CryptoIceMLH/SolarBit/Prototype/README.md

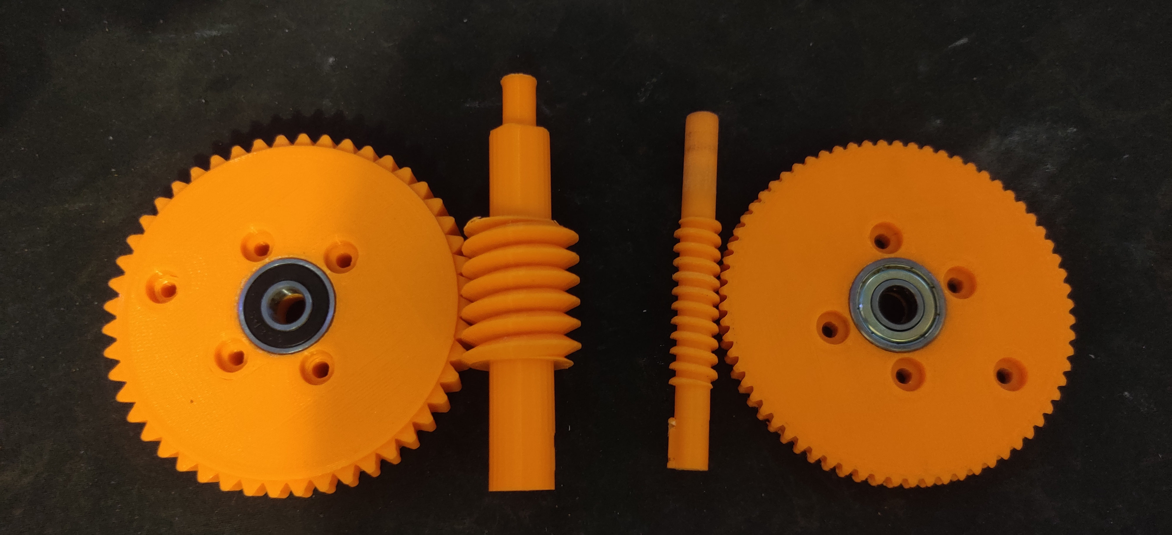
[picture p3: Prototype/IMG_20240215_163127.jpg]

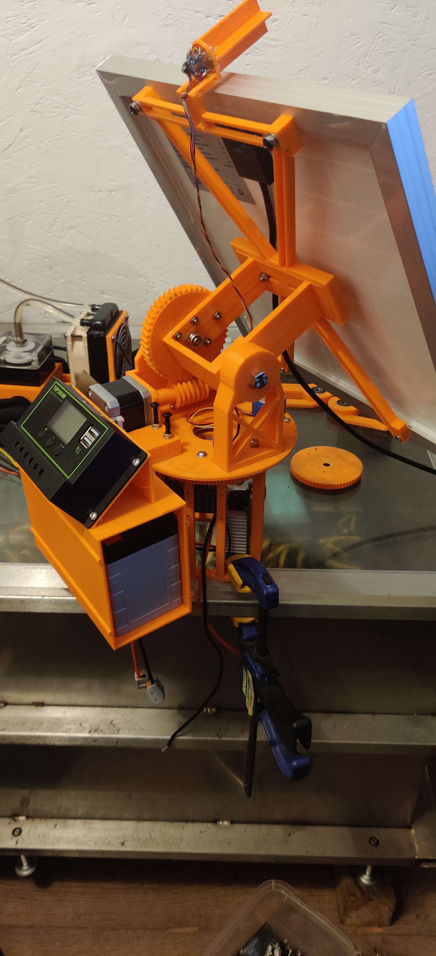
[picture p4: Prototype/IMG_20240217_124240.jpg]

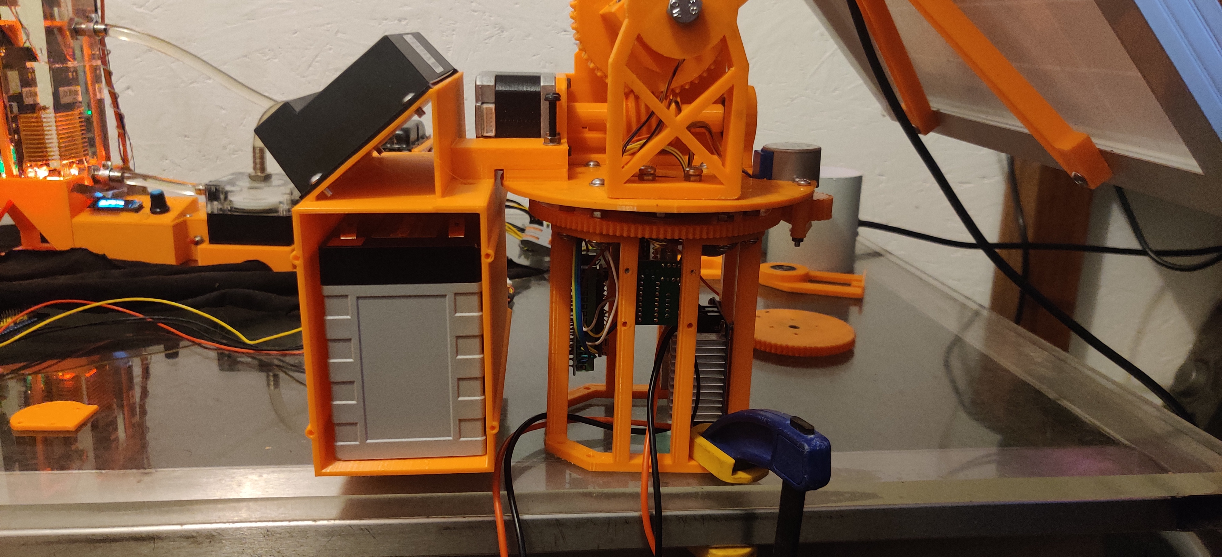
[picture p5: Prototype/IMG_20240217_124309.jpg]

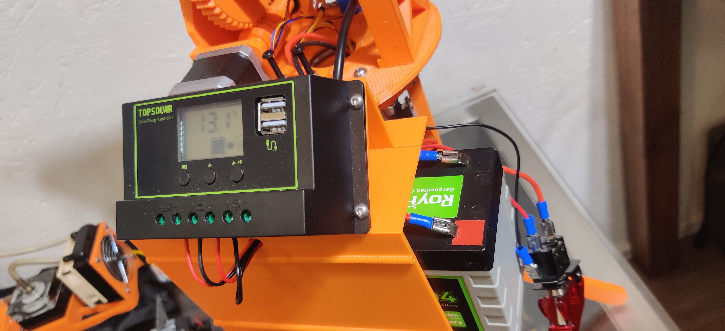
[picture p6: Prototype/IMG_20240220_164915.jpg]

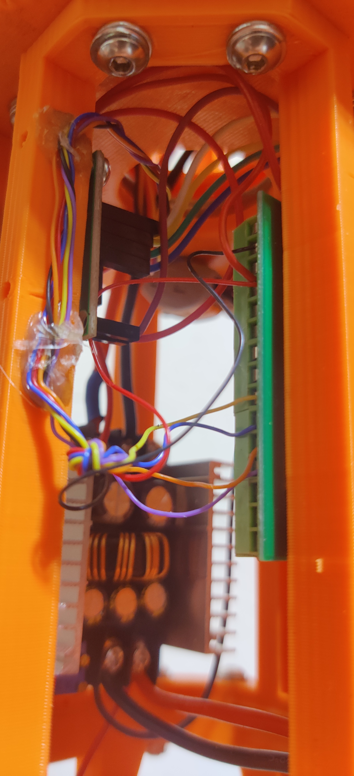
[picture p7: Prototype/IMG_20240220_165518.jpg]

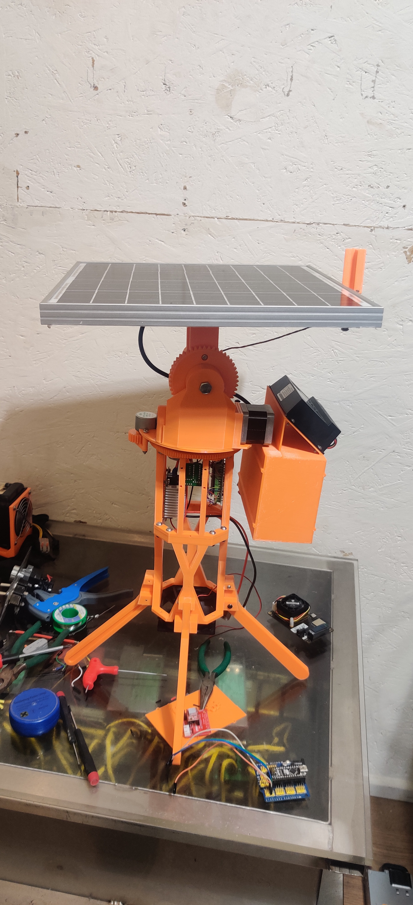
[picture p8: Prototype/IMG_20240220_183023.jpg]

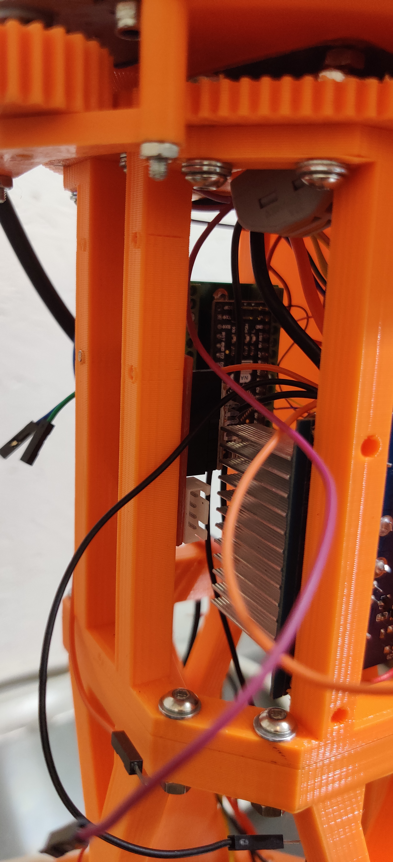
[picture p9: Prototype/IMG_20240314_140523.jpg]

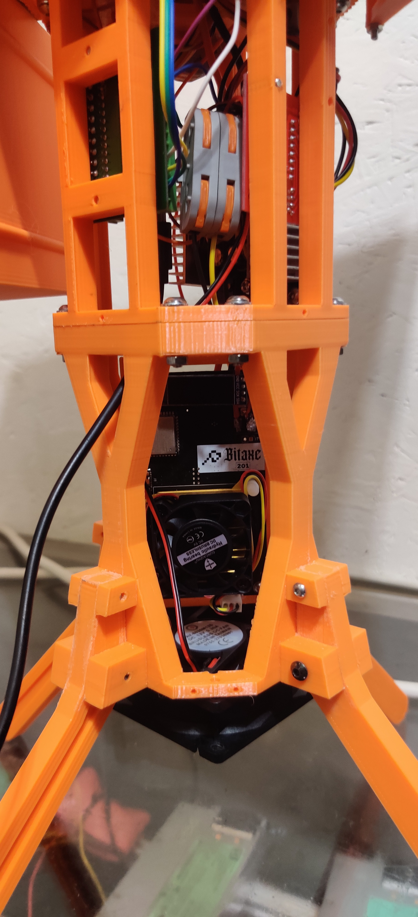
[picture p10: Prototype/IMG_20240314_154743.jpg]

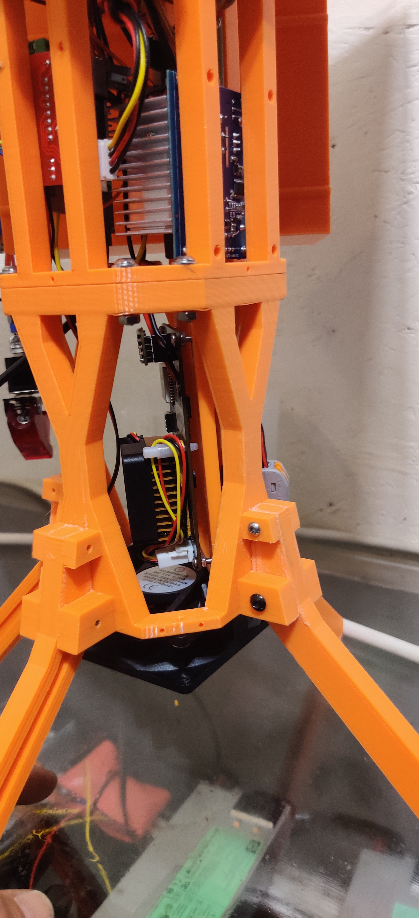
[picture p11: Prototype/IMG_20240314_154749.jpg]

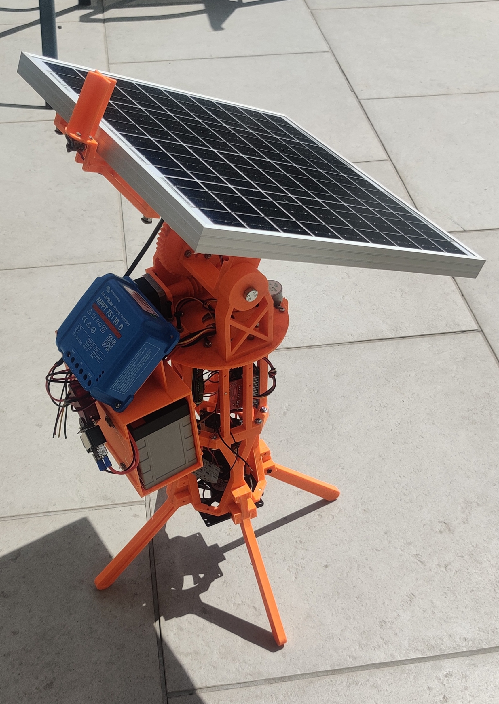
[picture p12: Prototype/IMG_20240616_144431.jpg]


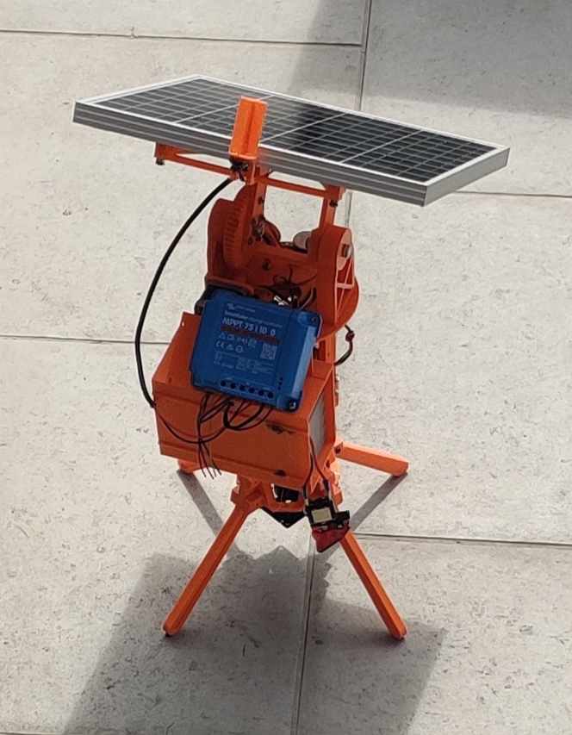
[picture p14: Prototype/IMG_20240618_124644.jpg]

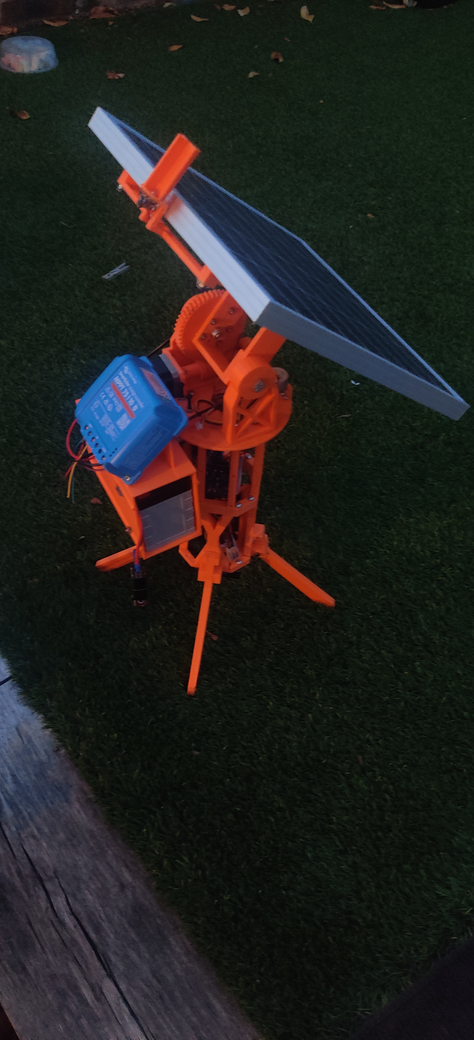
[picture p15: Prototype/IMG_20240717_213533.jpg]

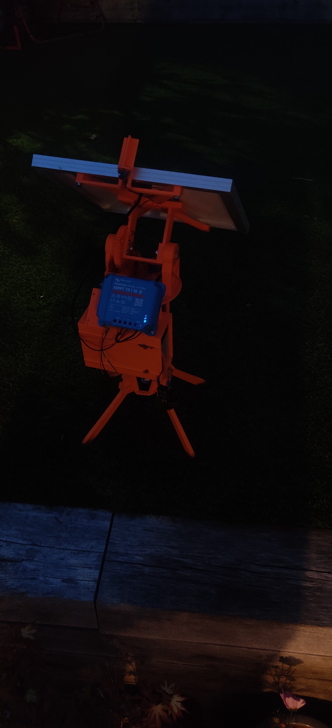
[picture p16: Prototype/IMG_20240717_214945.jpg]
