CryptoIceMLH/SolarBit/img/Gk3GHBeXMAATnz1.jpg

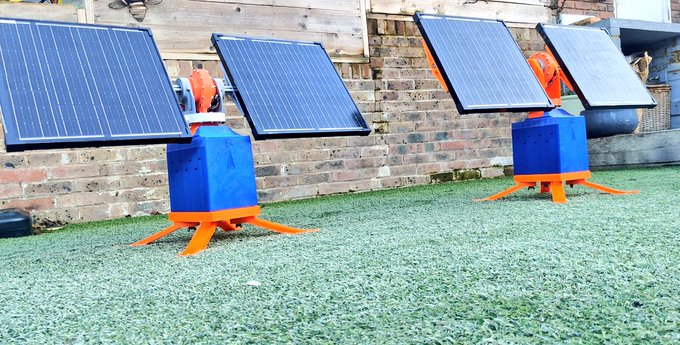
img/Gk3GHBeXMAATnz1.jpg
