CryptoIceMLH/SolarBit/img/SolarbitColorCode.jpg

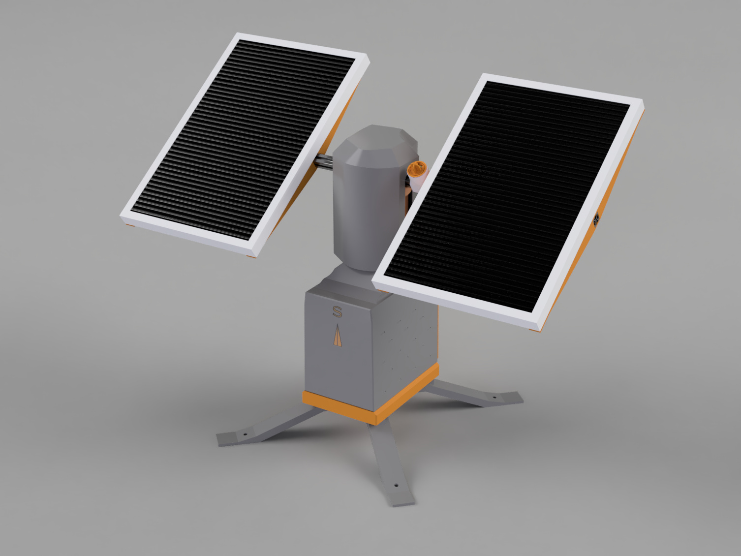
img/SolarbitColorCode.jpg
