CryptoIceMLH/SolarBit/img/SolarbitColorCode.png

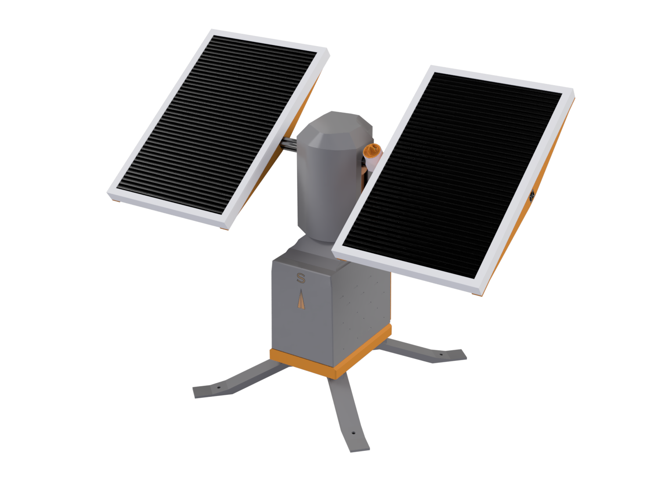
img/SolarbitColorCode.png
