CryptoIceMLH/SolarBit/3D Files/Cable Management/CableClip.stl

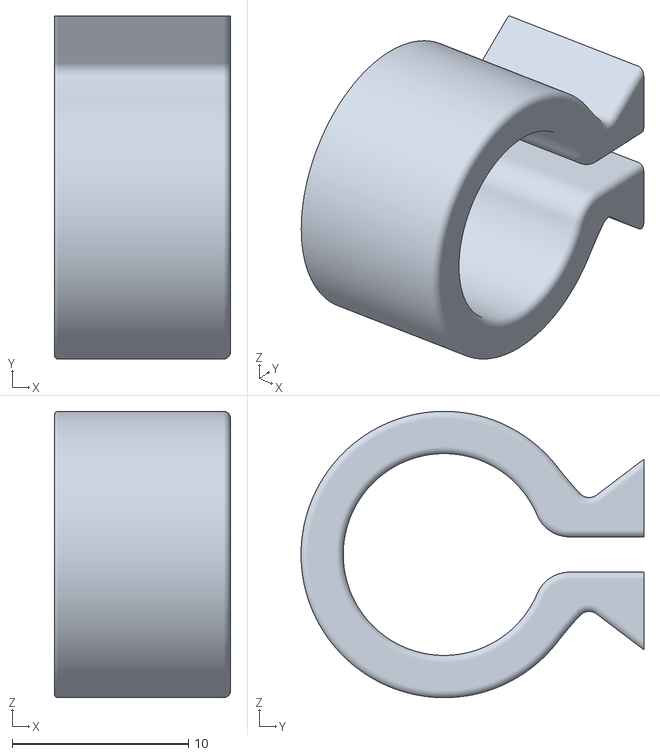
[picture p20: CAD file, 2025-05-01]
3D Files/Cable Management/CableClip.stl
10.0 x 19.5 x 16.3
