CryptoIceMLH/SolarBit/3D Files/Limit Switch Trigger/FlapTrigger.stl

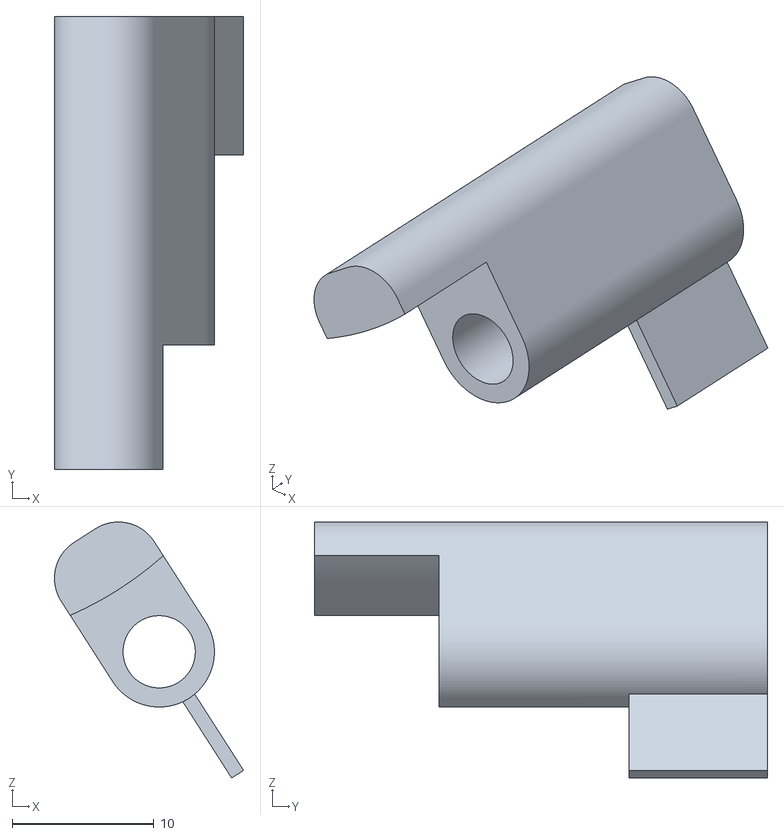
[picture p21: CAD file, 2025-05-01]
3D Files/Limit Switch Trigger/FlapTrigger.stl
13.3 x 32.0 x 18.1
