CryptoIceMLH/SolarBit/3D Files/Tools/HandCrank.stl

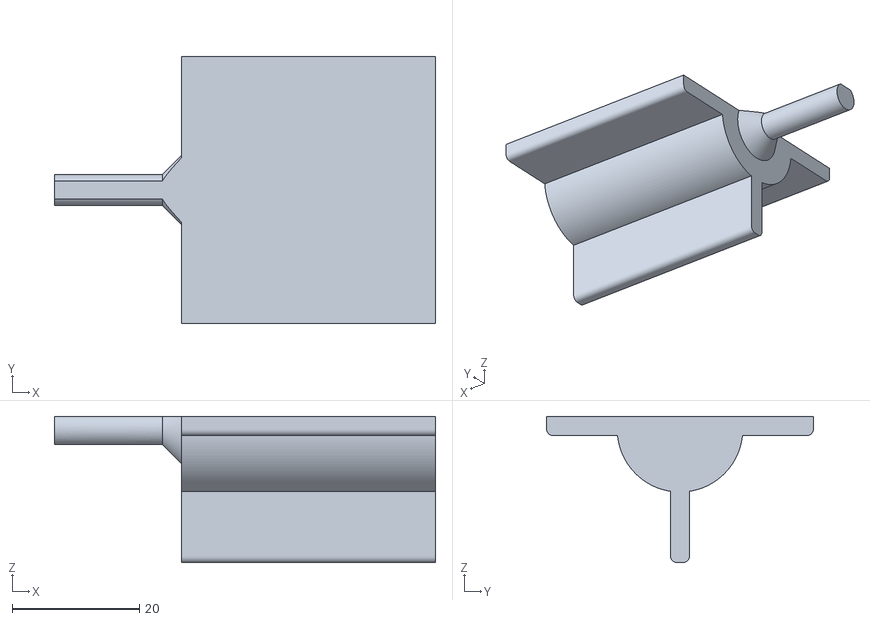
[picture p22: CAD file, 2025-05-01]
3D Files/Tools/HandCrank.stl
60.0 x 42.0 x 23.0
