CryptoIceMLH/SolarBit/(commit log)

2025-05-01 Add files
    open source everything
    [CableClip.stl, FlapTrigger.stl, HandCrank.stl]
2025-07-07 Create BOM solarbit V1.2 production - BOM Solarbit.csv
    [BOM solarbit V1.2 production - BOM Solarbit.csv]
2025-07-07 Update BOM solarbit V1.2 production - BOM Solarbit.csv
    [BOM solarbit V1.2 production - BOM Solarbit.csv]
