CryptoIceMLH/SolarBit/Prototype/IMG_20240617_082618.jpg

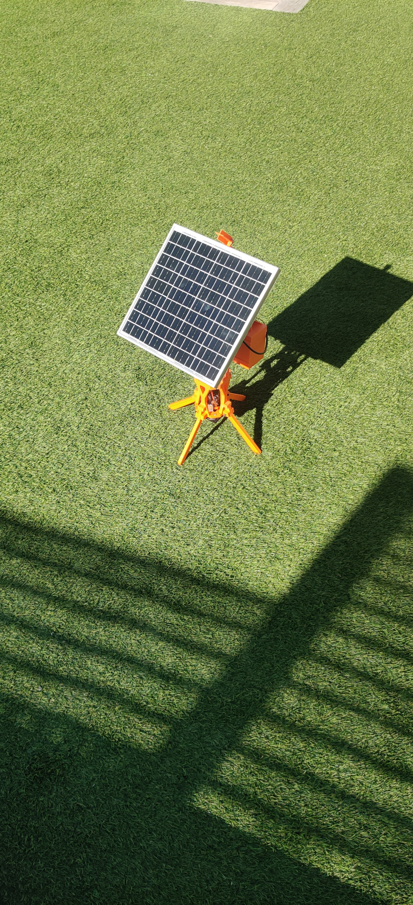
[picture p13: Prototype/IMG_20240617_082618.jpg]
Prototype/IMG_20240617_082618.jpg
